sbrulais/tinySensor/hardware/kicad/tinySensorv1.kicad_pcb

## KiCad design hardware/kicad/tinySensorv1.kicad_pcb (2020-02-24)

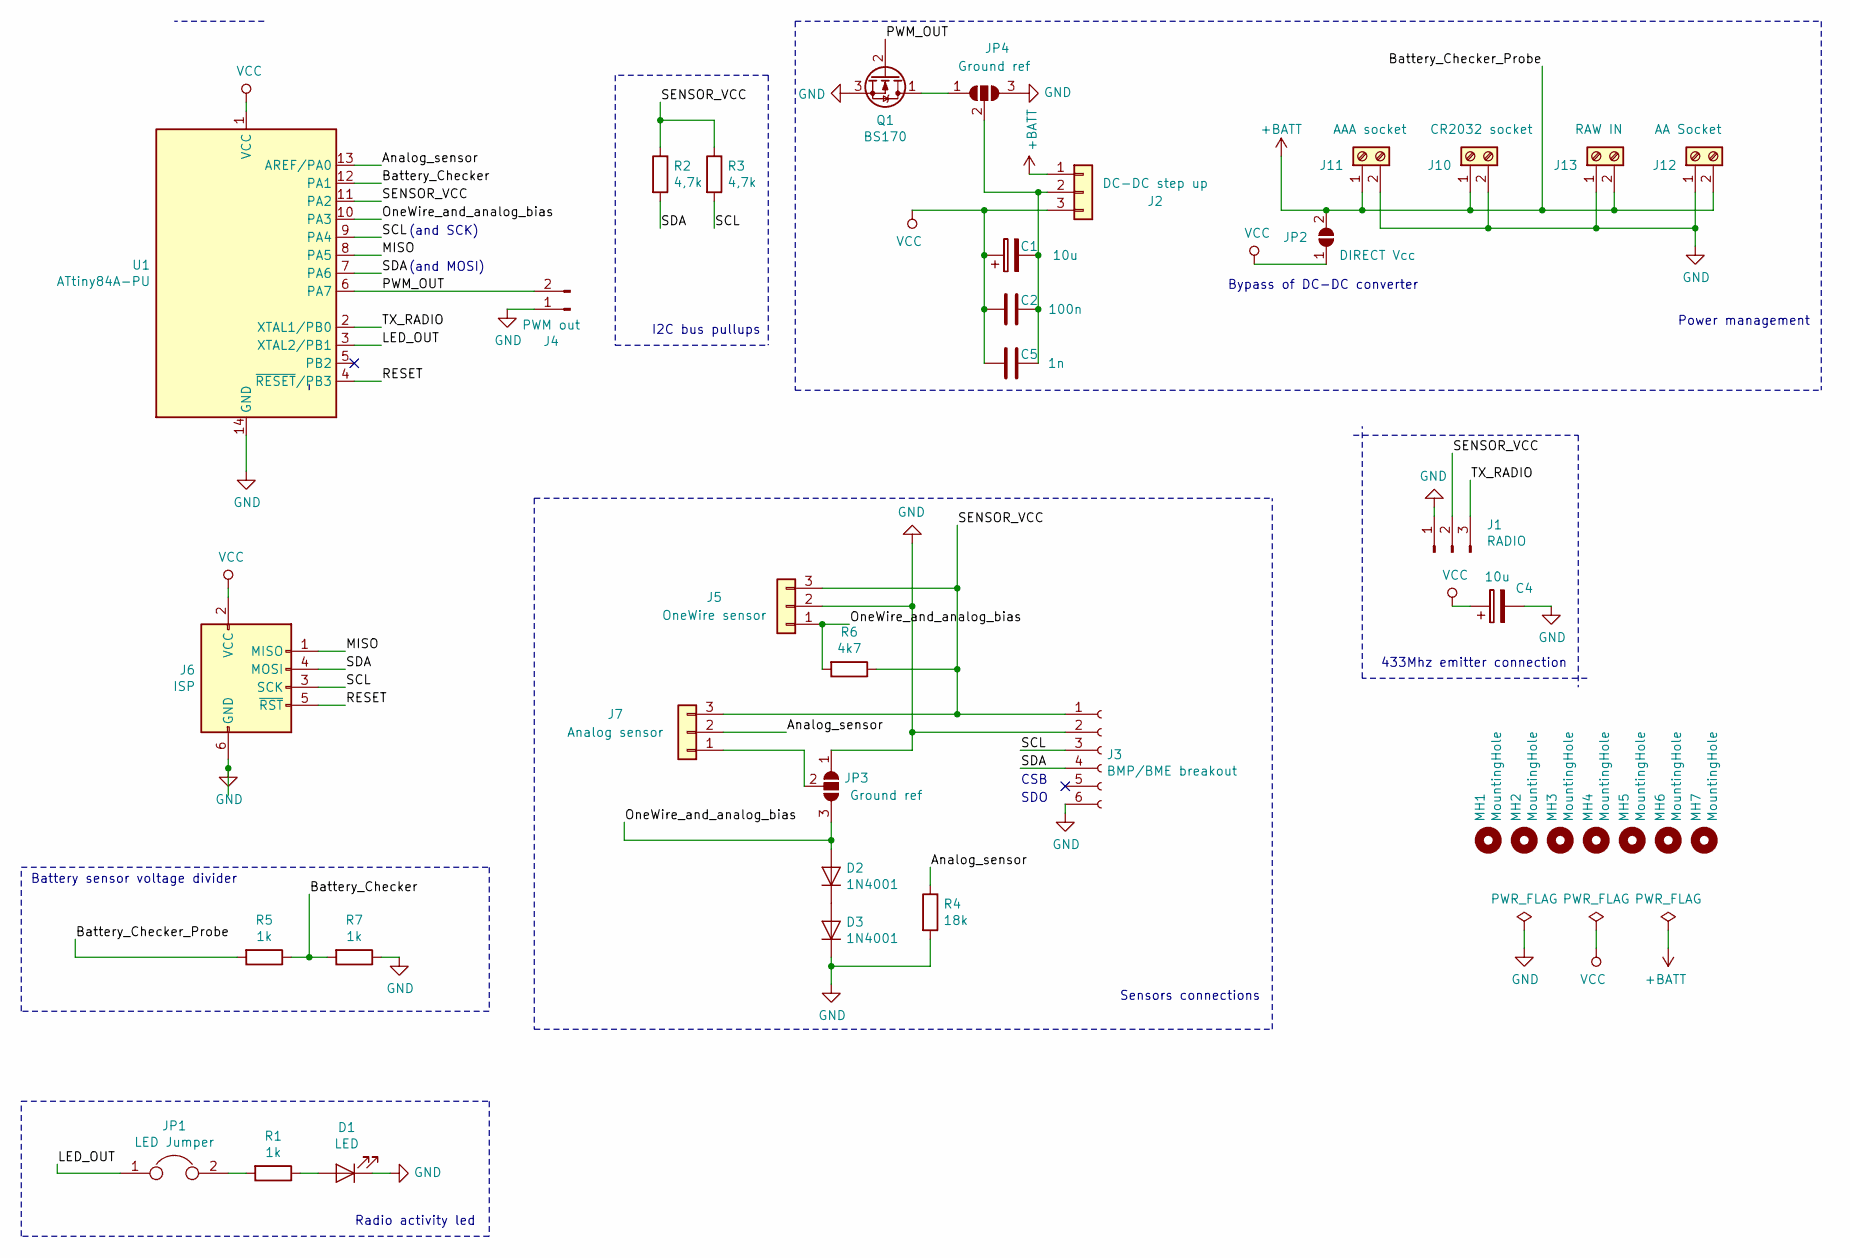
[picture p1: schematic tinySensorv1.sch, TinySensor board]

Parts:
C1, C4: 10u; CP_Radial_D5.0mm_P2.50mm
C2: 100n; C_Rect_L7.0mm_W2.0mm_P5.00mm
C5: 1n; CP_Radial_Tantal_D4.5mm_P2.50mm
D1: LED; LED_D1.8mm_W3.3mm_H2.4mm
D2, D3: 1N4001; D_DO-34_SOD68_P2.54mm_Vertical_AnodeUp
J1: RADIO; PinHeader_1x03_P2.54mm_Vertical
J2: DC-DC step up; PinHeader_1x03_P2.54mm_Vertical
J3: BMP/BME breakout; BMx280_breakout
J4: PWM out; PinHeader_1x02_P2.54mm_Vertical
J5: OneWire sensor; PinHeader_1x03_P2.54mm_Vertical
J6: ISP; ICSP_SOCKET_MINI_2x3
J7: Analog sensor; PinHeader_1x03_P2.54mm_Vertical
J10: CR2032 socket; BatteryHolder_Keystone_106_1x21mm
J11: AAA socket; BatteryHolder_Keystone_2466_1xAAA
J12: AA Socket; BatteryHolder_MPD_BH-18650-PC2
J13: RAW IN; TerminalBlock_bornier-2_P5.08mm
JP1: LED Jumper; PinHeader_1x02_P2.54mm_Vertical
JP2: DIRECT Vcc; SolderJumper-2_P1.3mm_Open_TrianglePad1.0x1.5mm
JP3, JP4: Ground ref; SolderJumper-3_P1.3mm_Open_Pad1.0x1.5mm_NumberLabels
MH1, MH2, MH3, MH4, MH5, MH6, MH7: MountingHole; MountingHole_2.5mm
Q1: BS170; TO-92_Inline
R1, R5, R7: 1k; R_Axial_DIN0204_L3.6mm_D1.6mm_P7.62mm_Horizontal
R2, R3: 4,7k; R_Axial_DIN0204_L3.6mm_D1.6mm_P7.62mm_Horizontal
R4: 18k; R_Axial_DIN0204_L3.6mm_D1.6mm_P7.62mm_Horizontal
R6: 4k7; R_Axial_DIN0204_L3.6mm_D1.6mm_P7.62mm_Horizontal
U1: ATtiny84A-PU; DIP-14_W7.62mm

Connections:
+BATT: J2.1, J10.1, J11.1, J12.2, J13.2, JP2.2 (B), R5.2
/Analog_sensor: J7.2, R4.1, U1.13 (AREF/PA0)
/Battery_Checker: R5.1, R7.2, U1.12 (PA1)
/LED_OUT: JP1.1, U1.3 (XTAL2/PB1)
/MISO: J6.1 (MISO), U1.8 (PA5)
/OneWire_and_analog_bias: D2.2 (A), J5.1, JP3.3 (B), R6.2, U1.10 (PA3)
/PWM_OUT: J4.2, Q1.2 (G), U1.6 (PA7)
/RESET: J6.5 (~RST), U1.4 (~RESET~/PB3)
/SCL: J3.3, J6.3 (SCK), R3.2, U1.9 (PA4)
/SDA: J3.4, J6.4 (MOSI), R2.2, U1.7 (PA6)
/SENSOR_VCC: J1.2, J3.1, J5.3, J7.3, R2.1, R3.1, R6.1, U1.11 (PA2)
/TX_RADIO: J1.3, U1.2 (XTAL1/PB0)
GND: C4.2, D1.1 (K), D3.1 (K), J1.1, J3.2, J3.6, J4.1, J5.2, J6.6 (GND), J10.2, J11.2, J12.1, J13.1, JP3.1 (A), JP4.3 (B), Q1.3 (S), R4.2, R7.1, U1.14 (GND)
unnamed: C1.2, C2.1, C5.1, J2.2, JP4.2 (C)
unnamed: D1.2 (A), R1.1
unnamed: D2.1 (K), D3.2 (A)
unnamed: J7.1, JP3.2 (C)
unnamed: JP1.2, R1.2
unnamed: JP4.1 (A), Q1.1 (D)
VCC: C1.1, C2.2, C4.1, C5.2, J2.3, J6.2 (VCC), JP2.1 (A), U1.1 (VCC)

Notes on the sheet:
SDO
CSB
Power management
I2C bus pullups
433Mhz emitter connection
(and SCK)
(and MOSI)
Sensors connections
Radio activity led
Bypass of DC-DC converter
Battery sensor voltage divider

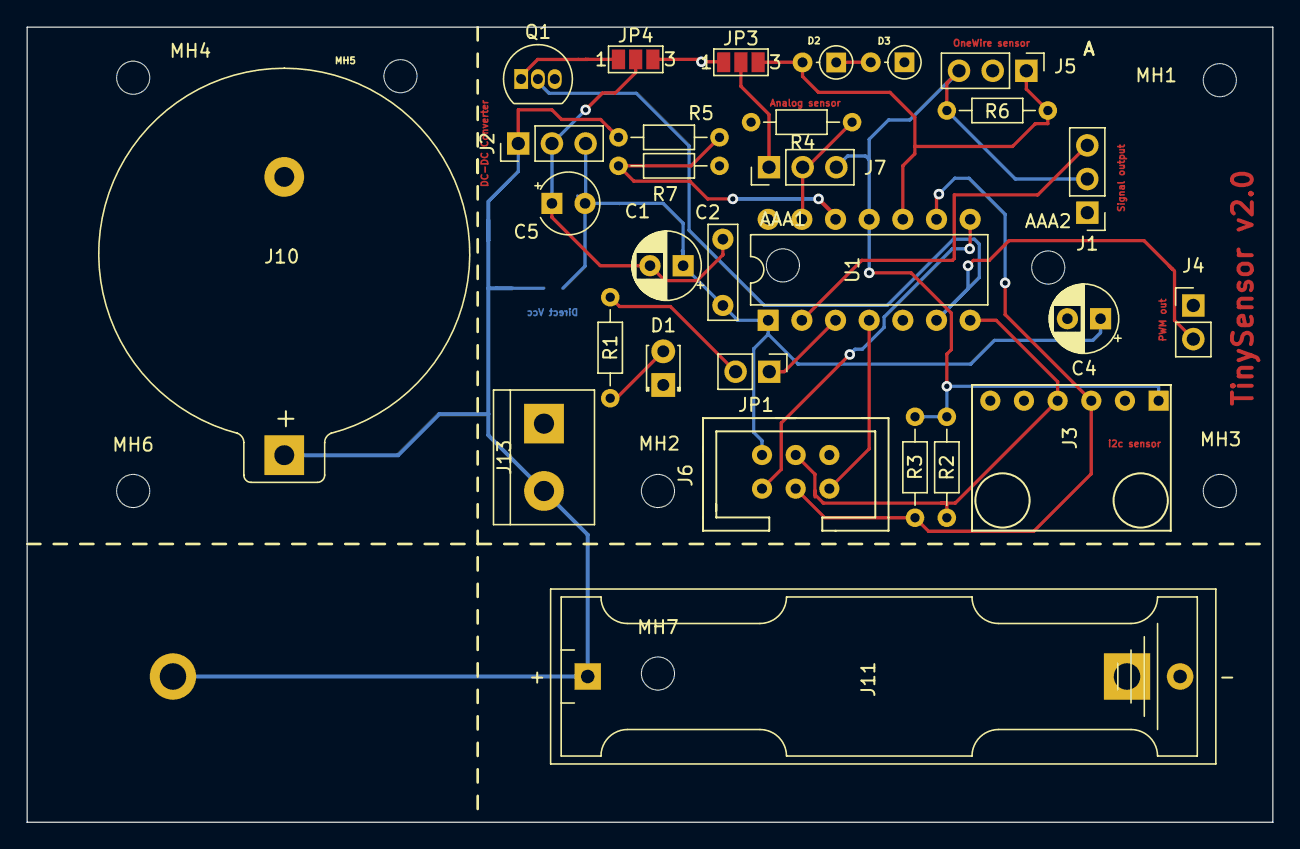
[picture p2: board tinySensorv1.kicad_pcb from above]

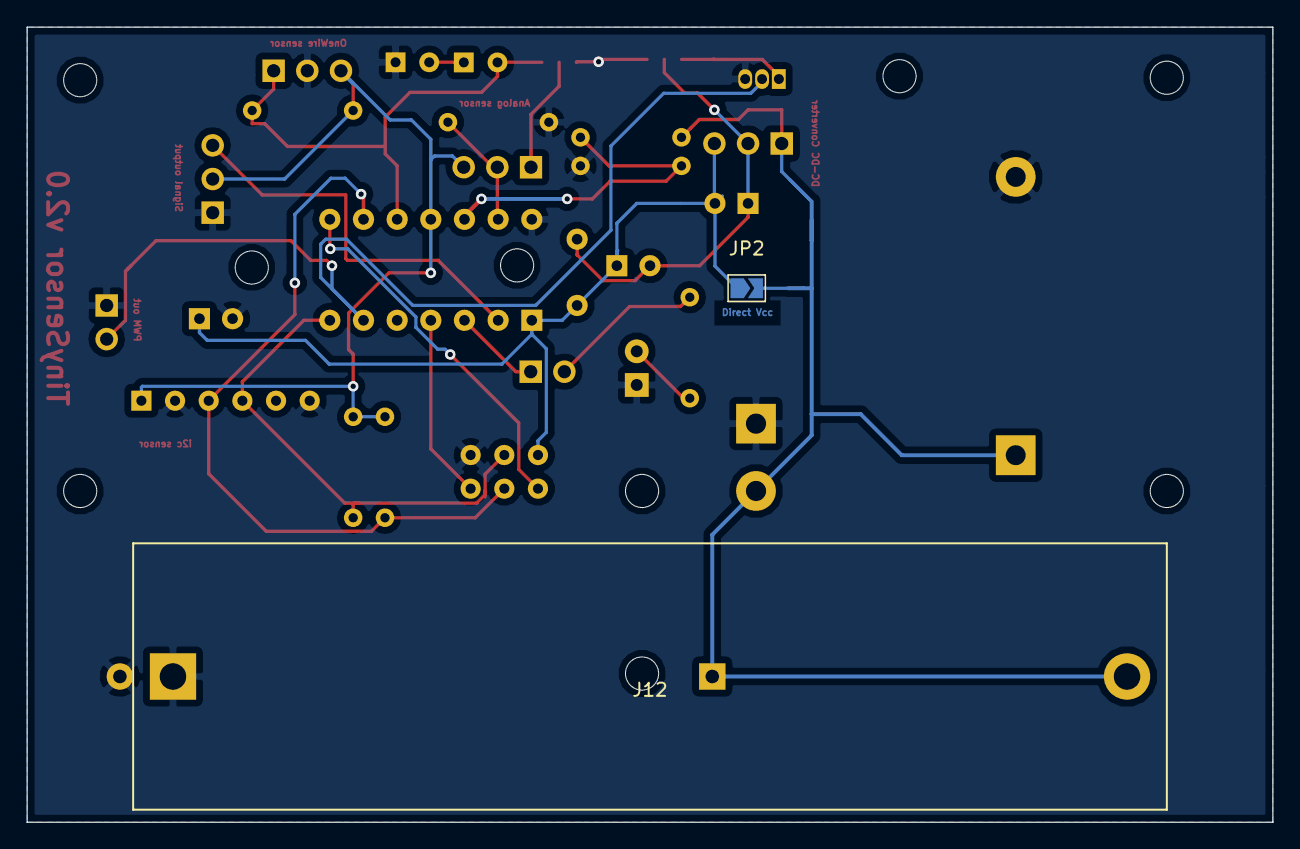
[picture p3: board tinySensorv1.kicad_pcb from below]

Board: 2 copper layers, 94.0 x 60.0 mm, 40 parts (2 on the bottom side), 20 nets.

Other parts of the board:
AAA1, AAA2: MountingHole; MountingHole_2.5mm
