sbrulais/tinySensor/hardware/eagle/tinySensor.brd

## EAGLE design hardware/eagle/tinySensor.brd (2021-04-30)

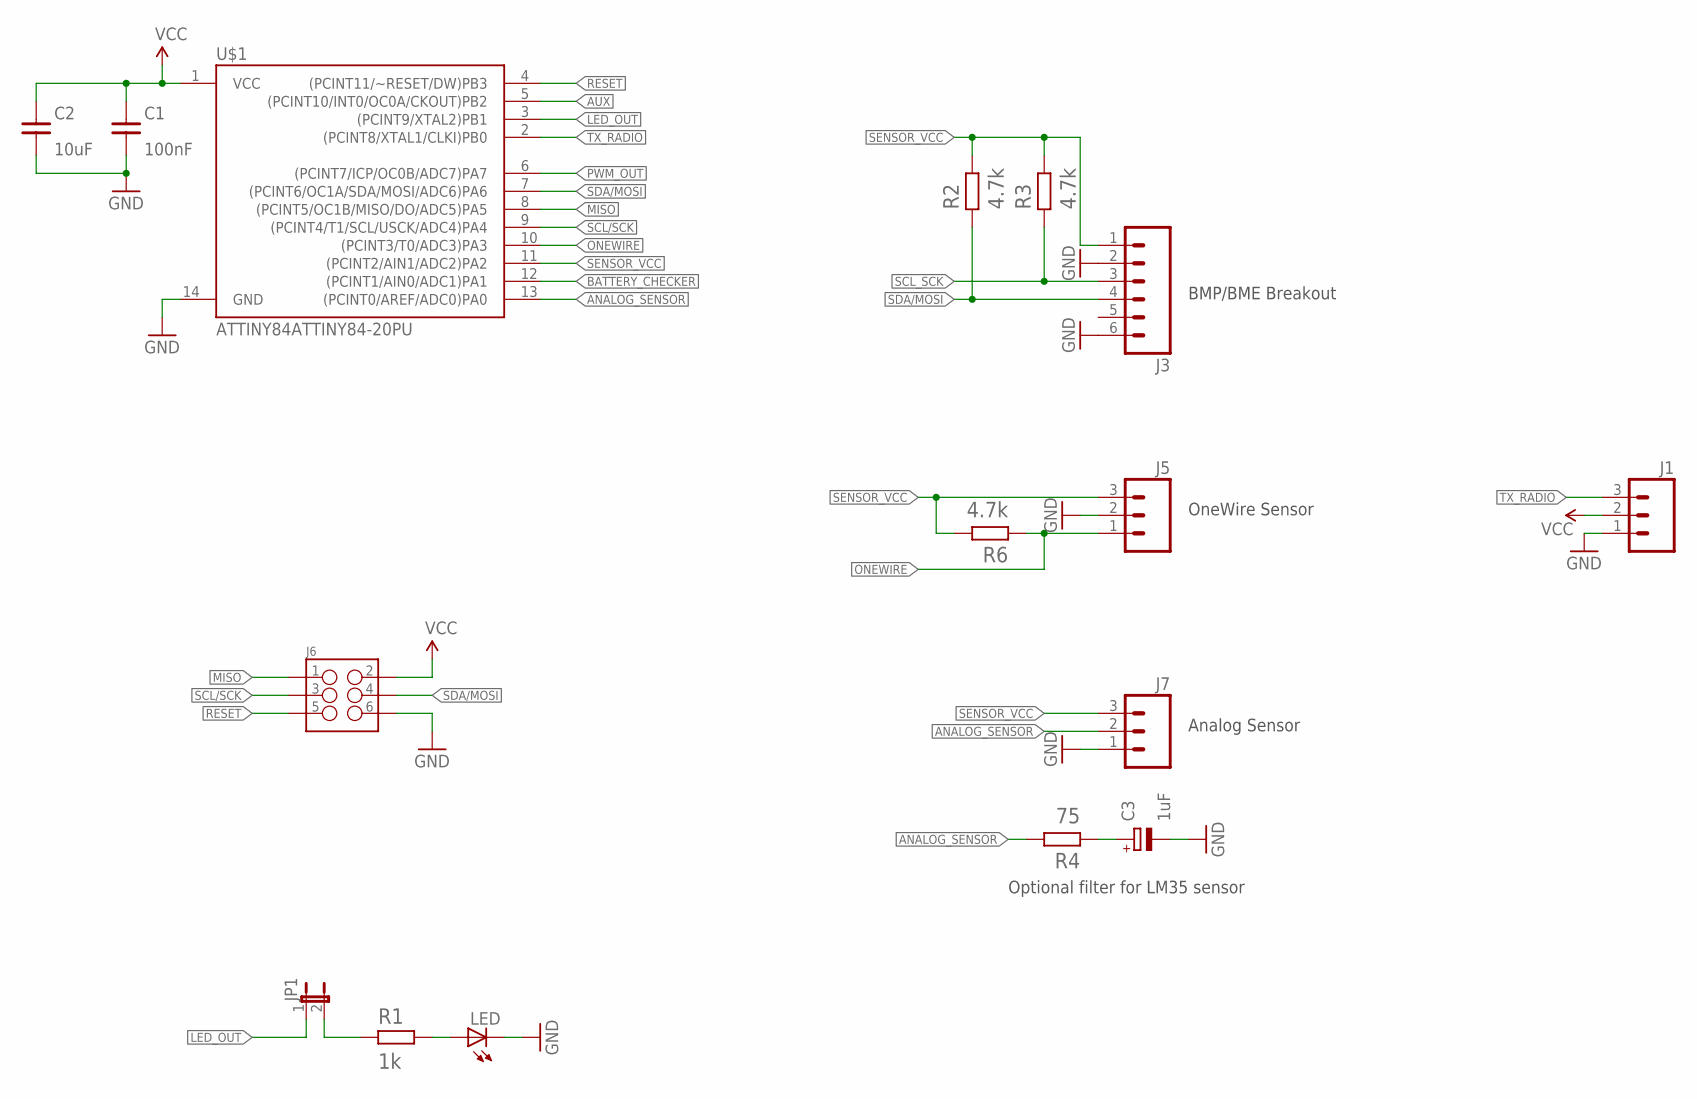
[picture p4: schematic tinySensor.sch]

Parts:
C1: 100nF; R0805
C2: 10uF; R0805
C3: 1uF; PANASONIC_C
J1, J5, J7: M03PTH; 1X03
J3: M06SIP; 1X06
J6: M03X2SHROUD; 2X3-SHROUDED
JP1: JUMPER-2PTH; 1X02
LED: LED3MM
R1: 1k; R0805
R2, R3, R6: 4.7k; R0805
R4: 75; R0805
U$1: ATTINY84ATTINY84-20PU; DIL14

Connections:
ANALOG_SENSOR: J7.2, R4.2, U$1.13 ((PCINT0/AREF/ADC0)PA0)
AUX: U$1.5 ((PCINT10/INT0/OC0A/CKOUT)PB2)
BATTERY_CHECKER: U$1.12 ((PCINT1/AIN0/ADC1)PA1)
GND: C1.1, C2.1, C3.-, J1.1, J3.2, J3.6, J5.2, J6.6, J7.1, LED.K (C), U$1.14 (GND)
LED_OUT: JP1.1, U$1.3 ((PCINT9/XTAL2)PB1)
MISO: J6.1, U$1.8 ((PCINT5/OC1B/MISO/DO/ADC5)PA5)
unnamed: JP1.2, R1.1
unnamed: LED.A, R1.2
unnamed: C3.+, R4.1
ONEWIRE: J5.1, R6.1, U$1.10 ((PCINT3/T0/ADC3)PA3)
PWM_OUT: U$1.6 ((PCINT7/ICP/OC0B/ADC7)PA7)
RESET: J6.5, U$1.4 ((PCINT11/~RESET/DW)PB3)
SCL/SCK: J6.3, U$1.9 ((PCINT4/T1/SCL/USCK/ADC4)PA4)
SCL_SCK: J3.3, R3.1
SDA/MOSI: J3.4, J6.4, R2.1, U$1.7 ((PCINT6/OC1A/SDA/MOSI/ADC6)PA6)
SENSOR_VCC: J3.1, J5.3, J7.3, R2.2, R3.2, R6.2, U$1.11 ((PCINT2/AIN1/ADC2)PA2)
TX_RADIO: J1.3, U$1.2 ((PCINT8/XTAL1/CLKI)PB0)
VCC: C1.2, C2.2, J1.2, J6.2, U$1.1 (VCC)

Notes on the sheet:
BMP/BME Breakout
Analog Sensor
OneWire Sensor
Optional filter for LM35 sensor

Board: 2 copper layers, 16 parts (3 on the bottom side), 15 nets, no tracks yet.
