sbrulais/tinySensor/src/main.cpp

/*
* This file is part of the TinySensor distribution
* (https://github.com/arcadien/TinySensor)
*
* Copyright (c) 2019 Aurélien Labrosse
*
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
* You should have received a copy of the GNU General Public License
* along with this program. If not, see <http://www.gnu.org/licenses/>.
*/

#include <config.h>

#include <avr/interrupt.h>
#include <avr/io.h>
#include <avr/sleep.h>
#include <avr/wdt.h>
#include <string.h>
#include <ReadVcc.h>

#include <protocol/Oregon.h>
Oregon oregon;

#if defined(USE_DS18B20)
#include <ds18b20/ds18b20.h>
#endif

#if defined(USE_BME280) or defined(USE_BMP280)
#include <SparkFunBME280.h>
BME280 bmX280;
#endif

#include <Arduino.h>
#include <x10rf.h>
x10rf myx10 = x10rf(TX_RADIO_PIN, LED_PIN, 3);

#define rfxSensorID 12

void emitBatteryState()
{

	ADCSRA |= (1 << ADEN);
	_delay_ms(2);

	// discard first read
	int rawVccRead = analogRead(BAT_SENSOR_PIN);

	rawVccRead = analogRead(BAT_SENSOR_PIN);
	rawVccRead += analogRead(BAT_SENSOR_PIN);
	rawVccRead += analogRead(BAT_SENSOR_PIN);
	rawVccRead += analogRead(BAT_SENSOR_PIN);
	rawVccRead /= 4;

	ADCSRA &= ~(1 << ADEN);

	double MV_PER_ADC_STEPS = (ACTUAL_VCC_MV / 1024.);
	long voltage = round(MV_PER_ADC_STEPS * rawVccRead);
	myx10.RFXmeter(rfxSensorID, 0, voltage);
}

void UseLessPowerAsPossible()
{
	// AVR4013: picoPower Basics
	// unused pins should be set as
	// input + pullup to minimize consumption
	DDRA = 0;
	DDRB = 0;

	// pull-up all unused pins by default
	//
	PORTA |= 0b01111001;
	PORTB |= 0b11111100;

	// no timer1
	PRR &= ~_BV(PRTIM1);

	// no analog p. 129, 146, 131
	// PRR &= ~_BV(PRADC);
	// ADCSRA &= ~(1 << ADEN);
	// ACSR |= (1 << ACD);
	// DIDR0 |= (1 << ADC2D) | (1 << ADC1D); // buffers

	// deactivate brownout detection during sleep (p.36)
	MCUCR |= (1 << BODS) | (1 << BODSE);
	MCUCR |= (1 << BODS);
	MCUSR &= ~(1 << BODSE);
}

/*
* The firmware force emission of
* a signal every quarter of an hour
* even if sensor data does not change,
* just to be sure sensor is not out of
* power or bugged (900s)
*/
volatile uint16_t secondCounter;

/*!
* Interrupt routine called each 8 seconds in the
* default setup, which is the longest timeout period
* accepted by the hardware watchdog
*/
volatile uint8_t sleep_interval;
ISR(WATCHDOG_vect)
{
	wdt_reset();
	++sleep_interval;
	// Re-enable WDT interrupt
	_WD_CONTROL_REG |= (1 << WDIE);
}

void setup()
{
	wdt_disable();

	UseLessPowerAsPossible();

	secondCounter = 0;

	//Watchdog setup - 8s sleep time
	_WD_CONTROL_REG |= (1 << WDCE) | (1 << WDE);
	_WD_CONTROL_REG = (1 << WDP3) | (1 << WDP0) | (1 << WDIE);

// adc init
#if F_CPU > 12000000L
// above 12mhz, prescale by 128, the highest prescaler available
#define ADC_ARDUINO_PRESCALER B111
#elif F_CPU >= 6000000L
// 12 MHz / 64 ~= 188 KHz
// 8 MHz / 64 = 125 KHz
#define ADC_ARDUINO_PRESCALER B110
#elif F_CPU >= 3000000L
// 4 MHz / 32 = 125 KHz
#define ADC_ARDUINO_PRESCALER B101
#elif F_CPU >= 1500000L
// 2 MHz / 16 = 125 KHz
#define ADC_ARDUINO_PRESCALER B100
#elif F_CPU >= 750000L
// 1 MHz / 8 = 125 KHz
#define ADC_ARDUINO_PRESCALER B011
#elif F_CPU < 400000L
// 128 kHz / 2 = 64 KHz -> This is the closest you can get, the prescaler is 2
#define ADC_ARDUINO_PRESCALER B000
#else							   //speed between 400khz and 750khz
#define ADC_ARDUINO_PRESCALER B010 //prescaler of 4
#endif

	ADCSRA = (ADCSRA & ~((1 << ADPS2) | (1 << ADPS1) | (1 << ADPS0))) | (ADC_ARDUINO_PRESCALER << ADPS0) | (1 << ADEN);
	// enable a2d conversions

	// set output pins
	DDRB |= _BV(TX_RADIO_PIN);
	DDRA |= _BV(RADIO_POWER_PIN);
	DDRB |= _BV(LED_PIN);

#if defined(USE_I2C)
	TinyI2C.init();
#endif
}

/*
* Puts MCU to sleep for specified number of seconds
*
* As the hardware watchdog is set for timeout after 8s,
* the value used here will be divided by 8 (and rounded if needed).
* It is better to use a multiple of 8 as value.
*/
void sleep(uint8_t s)
{
	s >>= 3; // or s/8
	if (s == 0)
		s = 1;
	sleep_interval = 0;
	while (sleep_interval < s)
	{
		set_sleep_mode(SLEEP_MODE_PWR_DOWN);
		sleep_enable();
		sei();

		uint8_t PRR_backup = PRR;
		uint8_t porta_backup = PORTA;
		uint8_t portb_backup = PORTB;
		uint8_t ddra_backup = DDRA;
		uint8_t ddrb_backup = DDRB;

		PRR |= (1 << PRUSI);
		PRR |= (1 << PRTIM0);
		PRR |= (1 << PRTIM1);

		// all pins as input to avoid power draw
		DDRA = 0;
		DDRB = 0;

		// pull-up all unused pins by default
		PORTA |= 0b01110000;

		// pullup reset only
		// ( only 4 lasts are available - p. 67)
		PORTB |= 0b00001000;

		sleep_mode();
		// here the system is sleeping

		// here the system wakes up
		sleep_disable();

		// restore
		PRR = PRR_backup;
		DDRA = ddra_backup;
		DDRB = ddrb_backup;
		PORTA = porta_backup;
		PORTB = portb_backup;
	}
}
int avr_main(void)
{

	setup();

	oregon.setType(oregon._oregonMessageBuffer, OREGON_TYPE);
	oregon.setChannel(oregon._oregonMessageBuffer, Oregon::Channel::ONE);
	oregon.setId(oregon._oregonMessageBuffer, OREGON_ID);

#if defined(USE_BME280) || defined(USE_BMP280)
	bmX280.setI2CAddress(0x76);
	bmX280.beginI2C();
	bmX280.setStandbyTime(5);
#endif

// Buffer for Oregon message
#if OREGON_MODE == MODE_0
	uint8_t _lastOregonMessageBuffer[8] = {};
#elif OREGON_MODE == MODE_1
	uint8_t _lastOregonMessageBuffer[9] = {};
#elif OREGON_MODE == MODE_2
	uint8_t _lastOregonMessageBuffer[11] = {};
#else
#error mode unknown
#endif

	while (1)
	{

#if (defined(USE_BME280) || defined(USE_BMP280))
		oregon.setBatteryLevel(oregon._oregonMessageBuffer, 1);
		oregon.setTemperature(oregon._oregonMessageBuffer, bmX280.readTempC());

#if defined(USE_BME280)
		oregon.setHumidity(oregon._oregonMessageBuffer, bmX280.readFloatHumidity());
		oregon.setPressure(oregon._oregonMessageBuffer,
						   (bmX280.readFloatPressure() / 100));
#endif
		oregon.calculateAndSetChecksum(oregon._oregonMessageBuffer);
#endif

#if defined(USE_DS18B20)

		ds18b20convert(&PORTA, &DDRA, &PINA, (1 << 3), nullptr);

		// Delay (sensor needs time to perform conversion)
		_delay_ms(1000);

		// Read temperature (without ROM matching)
		int16_t temperature = 0;
		ds18b20read(&PORTA, &DDRA, &PINA, (1 << 3), nullptr, &temperature);

		oregon.setBatteryLevel(oregon._oregonMessageBuffer, 1);
		oregon.setTemperature(oregon._oregonMessageBuffer, temperature / 16);
		oregon.calculateAndSetChecksum(oregon._oregonMessageBuffer);

#endif

		bool shouldEmitData = false;

#if (OREGON_MODE == MODE_0)
		// temp update?
		shouldEmitData =
			(oregon._oregonMessageBuffer[4] != _lastOregonMessageBuffer[4] ||
			 oregon._oregonMessageBuffer[5] != _lastOregonMessageBuffer[5] ||
			 oregon._oregonMessageBuffer[6] != _lastOregonMessageBuffer[6]);

#elif (OREGON_MODE == MODE_1)
		// temp or humidity update?
		shouldEmitData =
			(oregon._oregonMessageBuffer[4] != _lastOregonMessageBuffer[4] ||
			 oregon._oregonMessageBuffer[5] != _lastOregonMessageBuffer[5] ||
			 oregon._oregonMessageBuffer[6] != _lastOregonMessageBuffer[6] ||
			 oregon._oregonMessageBuffer[7] != _lastOregonMessageBuffer[7]);
#elif (OREGON_MODE == MODE_2)
		// temp, humidity or pressure update?
		shouldEmitData =
			(oregon._oregonMessageBuffer[4] != _lastOregonMessageBuffer[4] ||
			 oregon._oregonMessageBuffer[5] != _lastOregonMessageBuffer[5] ||
			 oregon._oregonMessageBuffer[6] != _lastOregonMessageBuffer[6] ||
			 oregon._oregonMessageBuffer[7] != _lastOregonMessageBuffer[7] ||
			 oregon._oregonMessageBuffer[8] != _lastOregonMessageBuffer[8] ||
			 oregon._oregonMessageBuffer[9] != _lastOregonMessageBuffer[9]);
#else
#error OREGON_MODE has an unknown value
#endif

		// absolute counter for emission ~ each 15 minutes
		if (secondCounter > 900)
		{
			secondCounter = 0;
			shouldEmitData = true;
		}

		// led on
		PORTB |= _BV(LED_PIN);

		if (shouldEmitData)
		{
			// Activate radio power
			PORTA |= _BV(RADIO_POWER_PIN);
			_delay_ms(2);

			emitBatteryState();

			// led off here, it will allow a short
			// blink when actually emitting new data
			PORTB &= ~_BV(LED_PIN);

// Buffer for Oregon message
#if OREGON_MODE == MODE_0
			memcpy(_lastOregonMessageBuffer, oregon._oregonMessageBuffer, 8);
#elif OREGON_MODE == MODE_1
			memcpy(_lastOregonMessageBuffer, oregon._oregonMessageBuffer, 9);
#elif OREGON_MODE == MODE_2
			memcpy(_lastOregonMessageBuffer, oregon._oregonMessageBuffer, 11);
#else
#error mode unknown
#endif

			oregon.txPinLow();
			_delay_us(oregon.TWOTIME * 8);

			oregon.sendOregon(oregon._oregonMessageBuffer,
							  sizeof(oregon._oregonMessageBuffer));

			// pause before new transmission
			oregon.txPinLow();
			_delay_us(oregon.TWOTIME * 8);

			// second emission with led on
			PORTB |= _BV(LED_PIN);

			oregon.sendOregon(oregon._oregonMessageBuffer,
							  sizeof(oregon._oregonMessageBuffer));

			// radio off
			PORTA &= ~_BV(RADIO_POWER_PIN);
		}
		// led off
		PORTB &= ~_BV(LED_PIN);

		sleep(SLEEP_TIME_IN_SECONDS);
		secondCounter += SLEEP_TIME_IN_SECONDS;
	}
}
