sbrulais/tinySensor/(commit log)

2020-02-09 feat: Now able to sense and emit battery level
    * VBatt voltage is sent using the X10 protocol
2020-02-16 feat: Last enhancements from hardware testing
    * Full LM35 support: <0 temp with diode support
    * 433Mhz emitter is powered by SENSOR_VCC
    * Enhanced layout
    [tinySensorv1.kicad_pcb, tinySensorv1.sch]
2020-02-20 layout enhancements
    [tinySensorv1.kicad_pcb]
2020-02-24 feat: Allow shutdown of DCDC stepup
    [tinySensorv1.kicad_pcb, tinySensorv1.sch]
2021-04-30 Created eagle project
    [tinySensor.brd, tinySensor.sch]
2021-04-30 Schematics redrawn, work in progress
    [tinySensor.brd, tinySensor.sch]
